stoatworks-labs/canary/docs/renders/bottom.png

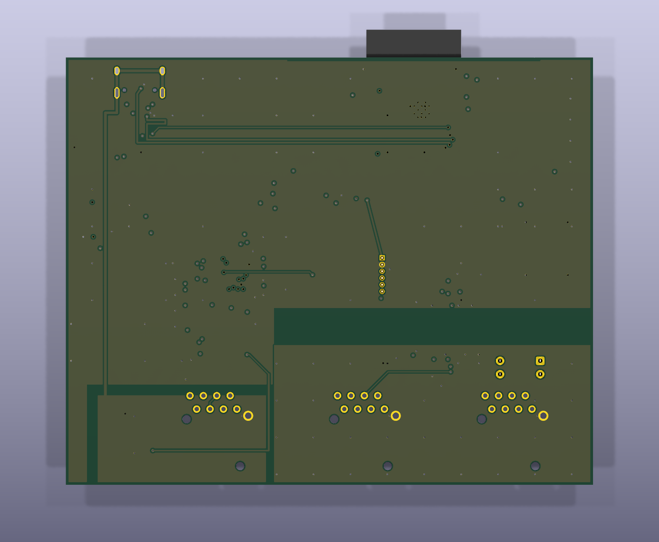
docs/renders/bottom.png
