stoatworks-labs/canary/docs/renders/top.png

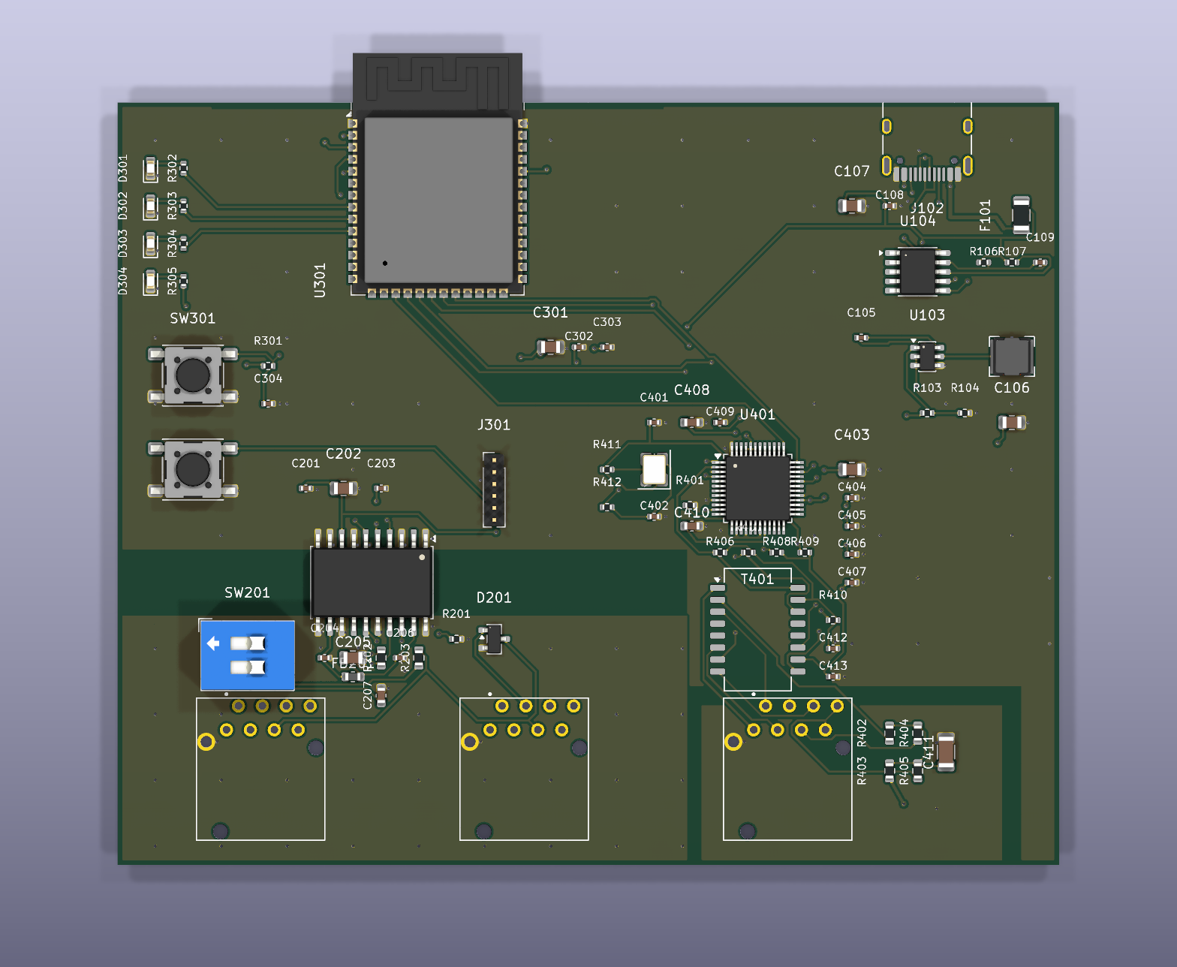
docs/renders/top.png
