stoatworks-labs/canary/hardware/fab/generic/canary-bom.csv

Item | Qty | References | Value | Footprint | Description | Manufacturer | MPN | LCSC | Mount | DNP | Notes
1 | 14 | C105,C108,C201,C203,C204,C206,C302-C304,C404-C407,C409 | 100nF (BST) / 100nF / 100nF (VBG) | C_0402_1005Metric | CAP CER 100nF 16V X7R 0402 | Samsung Electro-Mechanics | CL05B104KO5NNNC | C1525 | smt |  | DigiKey UK 8,392,367 in stock 2026-07-26
2 | 2 | C106,C301 | 22uF 16V / 22uF | C_0805_2012Metric | CAP CER 22uF 25V X5R 0805 | Samsung Electro-Mechanics | CL21A226MAQNNNE | C45783 | smt |  | was CL21A226MAQNNNE (Samsung): OBSOLETE, no longer manufactured; even Samsung's own CL21A226MAYNNNE replacement is out of stock. Substitute 55,097 in stock 2026-07-26. Same 0805, 25V X5R. | PCB Train UK alternate: KYOCERA AVX KGM21AR51E226MU
3 | 4 | C107,C202,C205,C403 | 10uF 16V / 10uF | C_0805_2012Metric | CAP CER 10uF 25V X5R 0805 | Samsung Electro-Mechanics | CL21A106KAYNNNE | C15850 | smt |  | was CL21A106KAYNNNE (Samsung): 0 stock at DigiKey UK, 49-week factory lead time. Substitute 275,536 in stock 2026-07-26. Same 0805 land pattern, same 25V X5R. | PCB Train UK alternate: Taiyo Yuden TMK212BBJ106KGHT
4 | 1 | C109 | 1uF | C_0402_1005Metric | CAP CER 1uF 25V X5R 0402 | Samsung Electro-Mechanics | CL05A105KA5NQNC | C52923 | smt |  | DigiKey UK 1,871,894 in stock 2026-07-26
5 | 1 | C207 | 4.7nF | C_0603_1608Metric | CAP CER 4.7nF 50V X7R 0603 | FH (Guangdong Fenghua Advanced Tech) | 0603B472K500NT | C53987 | smt |  | was 0603B472K500NT (Fenghua): China-domestic, not stocked in the West. Substitute 3,125,426 in stock 2026-07-26. | PCB Train UK alternate: Samsung Electro-Mechanics CL10B472KB8NNNC
6 | 2 | C401,C402 | 18pF | C_0402_1005Metric | CAP CER 18pF 50V C0G/NP0 0402 | FH (Guangdong Fenghua Advanced Tech) | 0402CG180J500NT | C1549 | smt |  | was 0402CG180J500NT (Fenghua): China-domestic. Substitute 542,765 in stock 2026-07-26. C0G confirmed - these are the crystal load caps, so the dielectric matters. | PCB Train UK alternate: Samsung Electro-Mechanics CL05C180JB5NNNC
7 | 2 | C408,C410 | 4.7uF (1V2O) / 4.7uF (TOCAP) | C_0603_1608Metric | CAP CER 4.7uF 16V X5R 0603 | Samsung Electro-Mechanics | CL10A475KO8NNNC | C19666 | smt |  | DigiKey UK 118,638 in stock 2026-07-26
8 | 1 | C411 | 1nF 2kV | C_1206_3216Metric | CAP CER 1nF 2kV X7R 1206 | FH (Guangdong Fenghua Advanced Tech) | 1206B102K202NT | C9196 | smt |  | was 1206B102K202NT (Fenghua): China-domestic. Substitute confirmed 2000V X7R 1206, 295,090 in stock 2026-07-26. SAFETY-RELEVANT: this is the capacitor bridging the CAN isolation barrier - the 2kV rating is the reason it is a 1206. | PCB Train UK alternate: YAGEO CC1206KKX7RDBB102
9 | 1 | C412 | 10nF (TCT) | C_0402_1005Metric | CAP CER 10nF 50V X7R 0402 | Samsung Electro-Mechanics | CL05B103KB5NNNC | C15195 | smt |  | DigiKey UK 6,151,308 in stock 2026-07-26
10 | 1 | C413 | 6.8nF (RCT) | C_0402_1005Metric | CAP CER 6.8nF 50V X7R 0402 | YAGEO | CC0402KRX7R9BB682 | C93654 | smt |  | DigiKey UK 76,814 in stock 2026-07-26
11 | 1 | D201 | NUP2105L | SOT-23 | TVS DIODE 24VWM 44VC SOT-23 | TECH PUBLIC | NUP2105LT1G | C2890118 | smt |  | MANUFACTURER CORRECTED: the JLCPCB BOM credited this to 'TECH PUBLIC', which is a clone house. onsemi is the originator and DigiKey UK stocks it at GBP 0.33 2026-07-26. Buy the onsemi part - it is an ESD device on an isolated bus.
12 | 3 | D301,D303,D304 | LAN (green) / CAN (green) / ON (green) | LED_0603_1608Metric | LED GREEN CLEAR 0603 SMD | Hubei KENTO Elec | KT-0603G | C12624 | smt |  | was KT-0603G (Hubei KENTO): China-domestic. Substitute 1,892,900 in stock 2026-07-26. Active low, 1k series resistor - forward voltage is not critical. | PCB Train UK alternate: Lite-On Inc. LTST-C190KGKT
13 | 1 | D302 | ERR (red) | LED_0603_1608Metric | LED RED CLEAR 0603 SMD | Hubei KENTO Elec | KT-0603R | C2286 | smt |  | was KT-0603R (Hubei KENTO): China-domestic. Substitute 1,033,054 in stock 2026-07-26. Same Lite-On family as the greens, so one series and one datasheet covers all four LEDs. | PCB Train UK alternate: Lite-On Inc. LTST-C190KRKT
14 | 1 | F101 | PTC 1.1A | Fuse_1206_3216Metric | PTC RESETTABLE FUSE 1.1A HOLD 16V 1206 | BHFUSE | BSMD1206-110-30V | C21714343 | smt |  | was BSMD1206-110-30V (BHFUSE): China-domestic, rated 30V. **THE 30V RATING CANNOT BE MET IN 1206.** A survey of DigiKey UK's 1206 PPTCs at 1.1A hold found 16V to be the highest available (this part, 3,066 in stock); everything else was 6V. 16V is comfortable for the 5V VBUS this board actually runs on - CH224K is configured for a 5V contract - but it does NOT cover the 20V a PD supply could present if that ever changed. DESIGNER TO CONFIRM. The alternative is a larger package in rev B. Verified 2026-07-26. | PCB Train UK alternate: Bourns Inc. MF-NSMF110/16X-2
15 | 1 | FB201 | 600R@100MHz | L_0603_1608Metric | FERRITE BEAD 600 OHM @ 100MHz 0603 | Murata Electronics | BLM18AG601SN1D | C19330 | smt |  | DigiKey UK 2,148,543 in stock 2026-07-26
16 | 1 | J102 | USB-C 16P | USB_C_Receptacle_HRO_TYPE-C-31-M-12 | CONN RCPT USB-C 16P SMD | Korean Hroparts Elec | TYPE-C-31-M-12 | C165948 | smt |  | China-domestic, and the KiCad land pattern (USB_C_Receptacle_HRO_TYPE-C-31-M-12) is drawn for THIS part. Western 16-pin USB-C receptacles exist but pin and shell geometry vary between makers, so a swap cannot be assumed to drop in. FREE ISSUE is the low-risk route: buy from LCSC and send them in. If PCB Train are to source it, they must confirm the mechanical drawing against the footprint first.
17 | 3 | J201,J202,J401 | etherCON NE8FBH CAN A / etherCON NE8FBH CAN B / etherCON NE8FBH LAN | Neutrik_etherCON_NE8FBH | CONN RCPT ETHERCON CAT5 B-SERIES PCB | Neutrik | NE8FBH |  | tht |  | MPN ADDED - this line was blank on the JLCPCB BOM because JLC cannot hand-fit it. PCB Train do through-hole assembly, so unlike JLCPCB they CAN fit these. DigiKey UK GBP 6.31 2026-07-26.
18 | 1 | J301 | UART/debug 1.27mm | PinHeader_1x06_P1.27mm_Vertical | HEADER 1x6 1.27mm PITCH VERTICAL THROUGH-HOLE - NOT FITTED | DO NOT FIT | DO NOT FIT |  | tht |  | DO NOT FIT. A 1x6 1.27mm SINGLE-ROW THROUGH-HOLE header is an awkward part - the 1.27mm parts carried by DigiKey UK are all either dual-row or SMD (M50-3600642, 20021121-00006T4LF, FTSH-106-01-L-DV all checked and all wrong). This is only a UART/debug header and the ESP32-S3's native USB already gives console access, so it is not needed to bring the board up. Leave the holes empty and fit a header by hand if ever wanted.
19 | 1 | L102 | 2.2uH 2A | L_Bourns-SRN4018 | INDUCTOR 2.2uH 2.9A SHIELDED DRUM | BOURNS | SRN4018-2R2M | C913207 | smt |  | DigiKey UK 86,769 in stock 2026-07-26
20 | 1 | R103 | 31.6k 1% | R_0402_1005Metric | RES 31.6k 1% 0402 | UNI-ROYAL(Uniroyal Elec) | 0402WGF3162TCE | C11463 | smt |  | was UNI-ROYAL (China-domestic, not stocked in the West). DigiKey UK 1,526,832 in stock 2026-07-26. | PCB Train UK alternate: YAGEO RC0402FR-0731K6L
21 | 3 | R104,R107,R301 | 10k 1% / 10k | R_0402_1005Metric | RES 10k 1% 0402 | UNI-ROYAL(Uniroyal Elec) | 0402WGF1002TCE | C25744 | smt |  | was UNI-ROYAL (China-domestic). NOTE the -13 series code, not -07: RC0402FR-0710KL is the same value but had only 762 in stock, whereas -13 had 79,602 2026-07-26. Electrically identical. | PCB Train UK alternate: YAGEO RC0402FR-1310KL
22 | 5 | R106,R302-R305 | 1k | R_0402_1005Metric | RES 1k 1% 0402 | UNI-ROYAL(Uniroyal Elec) | 0402WGF1001TCE | C11702 | smt |  | was UNI-ROYAL (China-domestic, not stocked in the West). DigiKey UK 11,751,037 in stock 2026-07-26. | PCB Train UK alternate: YAGEO RC0402FR-071KL
23 | 2 | R201,R412 | 0R / 0R (XO series) | R_0402_1005Metric | RES 0 ohm jumper 0402 | UNI-ROYAL(Uniroyal Elec) | 0402WGF0000TCE | C17168 | smt |  | was UNI-ROYAL (China-domestic). DigiKey UK 10,726,477 in stock 2026-07-26. J-series because a jumper has no meaningful tolerance. | PCB Train UK alternate: YAGEO RC0402JR-070RL
24 | 2 | R202,R203 | 62R | R_0603_1608Metric | RES 62R 1% 0603 | UNI-ROYAL(Uniroyal Elec) | 0603WAF620JT5E | C23222 | smt |  | was UNI-ROYAL (China-domestic, not stocked in the West). DigiKey UK 51,612 in stock 2026-07-26. | PCB Train UK alternate: YAGEO RC0603FR-0762RL
25 | 1 | R401 | 12.4k 1% | R_0402_1005Metric | RES 12.4k 1% 0402 | UNI-ROYAL(Uniroyal Elec) | 0402WGF1242TCE | C11692 | smt |  | was UNI-ROYAL (China-domestic, not stocked in the West). DigiKey UK 582,138 in stock 2026-07-26. | PCB Train UK alternate: YAGEO RC0402FR-0712K4L
26 | 4 | R402-R405 | 75R | R_0603_1608Metric | RES 75R 1% 0603 | UNI-ROYAL(Uniroyal Elec) | 0603WAF750JT5E | C4275 | smt |  | was UNI-ROYAL (China-domestic, not stocked in the West). DigiKey UK 254,084 in stock 2026-07-26. | PCB Train UK alternate: YAGEO RC0603FR-0775RL
27 | 4 | R406-R409 | 49.9R 1% | R_0402_1005Metric | RES 49.9R 1% 0402 | UNI-ROYAL(Uniroyal Elec) | 0402WGF499JTCE | C25120 | smt |  | was UNI-ROYAL (China-domestic, not stocked in the West). DigiKey UK 1,249,726 in stock 2026-07-26. | PCB Train UK alternate: YAGEO RC0402FR-0749R9L
28 | 1 | R410 | 10R 1% | R_0402_1005Metric | RES 10R 1% 0402 | UNI-ROYAL(Uniroyal Elec) | 0402WGF100JTCE | C25077 | smt |  | was UNI-ROYAL (China-domestic, not stocked in the West). DigiKey UK 3,567,505 in stock 2026-07-26. | PCB Train UK alternate: YAGEO RC0402FR-0710RL
29 | 1 | R411 | 1M | R_0402_1005Metric | RES 1M 1% 0402 | UNI-ROYAL(Uniroyal Elec) | 0402WGF1004TCE | C26083 | smt |  | was UNI-ROYAL (China-domestic, not stocked in the West). DigiKey UK 1,711,666 in stock 2026-07-26. | PCB Train UK alternate: YAGEO RC0402FR-071ML
30 | 1 | SW201 | TERMINATE 120R | SW_DIP_SPSTx02_Slide_9.78x7.26mm_W7.62mm_P2.54mm | SWITCH DIP SLIDE SPST x2 2.54mm | CTS Electrocomponents | 206-2ST |  | tht |  | was unspecified on the JLCPCB BOM. 206-2ST is a 2-position SPST slide DIP switch, DigiKey UK 12,933 in stock 2026-07-26. CHECK THE FOOTPRINT: the board uses SW_DIP_SPSTx02_Slide_9.78x7.26mm_W7.62mm_P2.54mm and this part's body/row spacing needs confirming against it. This is the CAN bus termination switch - a passive mechanical switch, so getting it wrong costs a rework, not a redesign.
31 | 2 | SW301,SW302 | RESET / BOOT | SW_SPST_PTS645Sx43SMTR92 | SWITCH TACTILE SPST-NO 6mm SMD | C&K | PTS645SK43SMTR92LFS | C221871 | smt |  | DigiKey UK 103,472 in stock 2026-07-26
32 | 1 | T401 | PT61017PEL | Transformer_Ethernet_Bourns_PT61017PEL | XFMR LAN 10/100 BASE-T 350uH 1CT:1CT SMD | BOURNS | PT61017PEL | C124001 | smt |  | DigiKey UK 7,881 in stock 2026-07-26
33 | 1 | U103 | AP63200WU | TSOT-23-6 | IC REG BUCK ADJ 2A TSOT-23-6 | Diodes Incorporated | AP63200WU-7 | C2071868 | smt |  | **SUPPLY RISK.** DigiKey UK showed 0 stock and a 40-WEEK manufacturer lead time 2026-07-26; the AP63201/03/05 siblings were also at zero. It IS plentiful at LCSC (C2071868). Ask PCB Train to check their own channels (Mouser/RS were unreachable from here so are unchecked) and be ready to free-issue this one too. Do NOT let a substitute buck be chosen for you: the output is set by an external divider (R103/R401) and a fixed-output sibling would silently ignore it.
34 | 1 | U104 | CH224K | SSOP-10-1EP_3.9x4.9mm_P1mm_EP2.1x3.3mm | IC USB PD SINK CONTROLLER SSOP-10 | WCH(Jiangsu Qin Heng) | CH224K | C970725 | smt |  | **NO WESTERN SOURCE EXISTS.** DigiKey UK returns no results for CH224K at all 2026-07-26 - WCH sell through Chinese channels only. There is no cross-reference to give PCB Train, so FREE ISSUE is the only option short of redesigning the power input around a western PD controller. Buy from LCSC (C970725) and send them in with the boards.
35 | 1 | U201 | ADM3053BRWZ | SOIC-20W_7.5x12.8mm_P1.27mm | IC TXRX CAN ISOLATED w/ isoPower SOIC-20W | Analog Devices | ADM3053BRWZ-REEL7 | C117821 | smt |  | MPN shortened from ADM3053BRWZ-REEL7: '-REEL7' only specifies a 7-inch reel, and DigiKey UK lists the plain part (GBP 11.91) rather than that suffix 2026-07-26. Let the supplier choose packaging. Most expensive part on the board - check its price on the quote. | PCB Train UK alternate: Analog Devices Inc. ADM3053BRWZ
36 | 1 | U301 | ESP32-S3-WROOM-1-N8 | ESP32-S3-WROOM-1 | MODULE ESP32-S3 WIFI/BT 8MB FLASH | Espressif Systems | ESP32-S3-WROOM-1-N8 | C2913198 | smt |  | DigiKey UK GBP 4.29, in stock 2026-07-26
37 | 1 | U401 | W5500 | LQFP-48_7x7mm_P0.5mm | IC ETHERNET MAC+PHY SPI LQFP-48 | WIZNET | W5500 | C32843 | smt |  | DigiKey UK GBP 2.87, in stock 2026-07-26
38 | 1 | Y401 | 25MHz 10ppm | Crystal_SMD_3225-4Pin_3.2x2.5mm | CRYSTAL 25MHz 12pF 3.2x2.5mm 4-SMD | YXC Crystal Oscillators | X322525MOB4SI | C9006 | smt |  | was X322525MOB4SI (YXC): China-domestic. LOAD CAPACITANCE PRESERVED at 12pF, which is the number that matters - C401/C402 are 18pF precisely because CL is 12pF, so a CL=18pF crystal would need those changed to ~30pF and that is a schematic edit, not a substitution. STABILITY IS RELAXED: +/-30ppm against the original +/-10ppm. IEEE 802.3 allows +/-100ppm on 100BASE-TX, so 30ppm is comfortably inside what the W5500 needs - but it is a relaxation of a stated spec, so DESIGNER TO CONFIRM. Only 723 in stock 2026-07-26: fine for a handful of prototypes, reserve early for a run. | PCB Train UK alternate: Abracon LLC ABM8-25.000MHZ-12-R40-D3Y-T
