stoatworks-labs/canary/hardware/enclosure/3dp-tube/canary_case_assembly.step

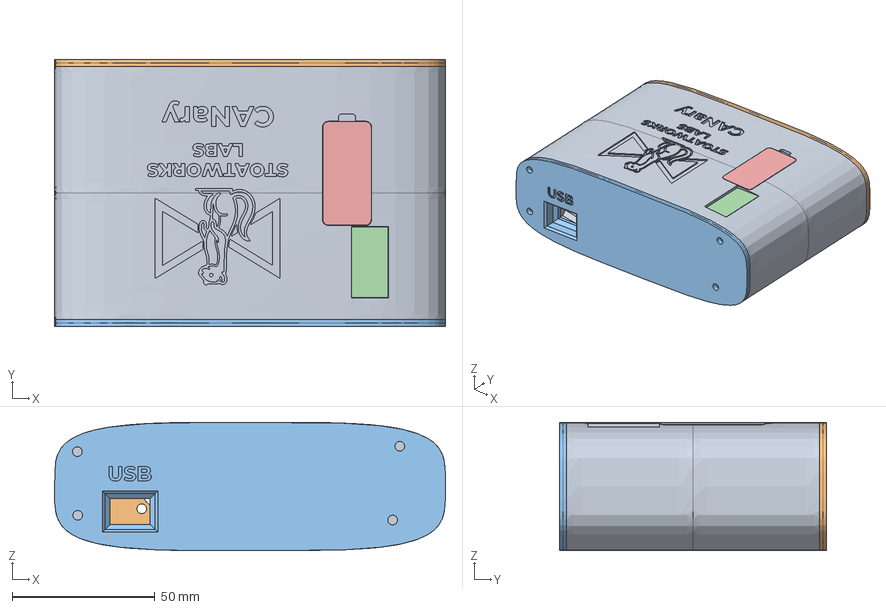
[picture p4: CAD file, 2026-09-27]
hardware/enclosure/3dp-tube/canary_case_assembly.step
137.0 x 93.5 x 45.0 mm
canary_tube
canary_end_front
canary_end_rear
canary_led_insert
canary_switch_cover
