stoatworks-labs/canary/hardware/enclosure/3dp-tube/canary_tube.step

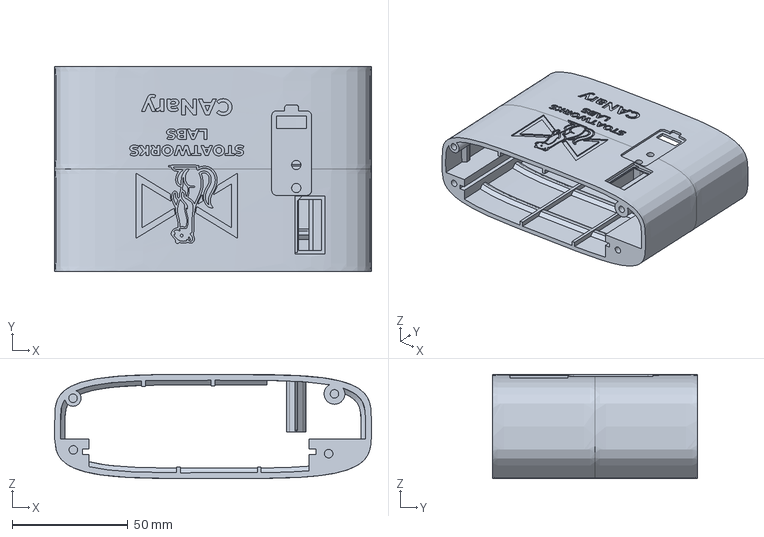
[picture p5: CAD file, 2026-09-27]
hardware/enclosure/3dp-tube/canary_tube.step
137.0 x 88.5 x 45.0 mm
