stoatworks-labs/canary/hardware/enclosure/canary-case-absgf-0.4-tube.3mf

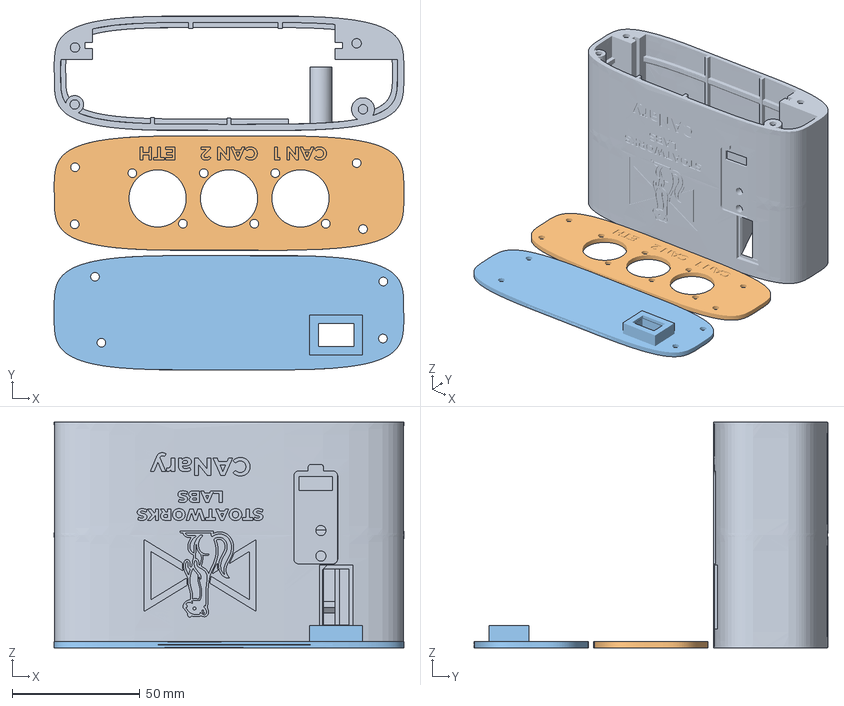
[picture p6: CAD file, 2026-09-27]
hardware/enclosure/canary-case-absgf-0.4-tube.3mf
137.1 x 138.7 x 88.5 mm
CANary case - body (one piece)
CANary case - end front (3x etherCON)
CANary case - end rear (USB-C)
