stoatworks-labs/canary/hardware/enclosure/jig/canary_jig_peg.step

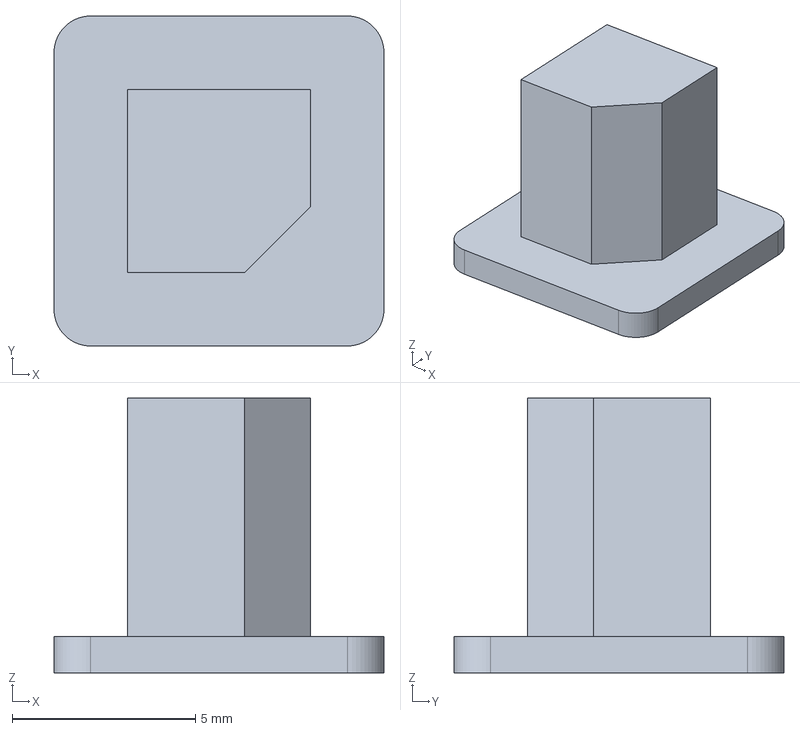
[picture p7: CAD file, 2026-09-27]
hardware/enclosure/jig/canary_jig_peg.step
9.00 x 9.00 x 7.50 mm
