stoatworks-labs/canary/hardware/enclosure/bambu/print-tube/canary_switch_cover.stl

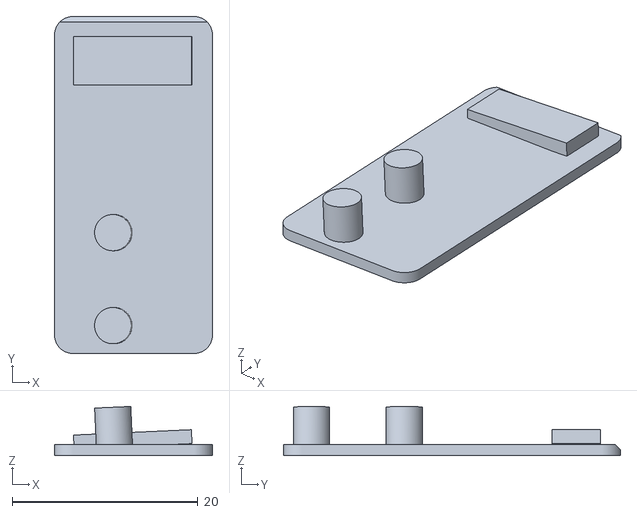
[picture p8: CAD file, 2026-09-27]
hardware/enclosure/bambu/print-tube/canary_switch_cover.stl
17.0 x 36.2 x 5.28
