stoatworks-labs/canary/hardware/enclosure/canary-4up-absgf-0.4-tube-x4.3mf

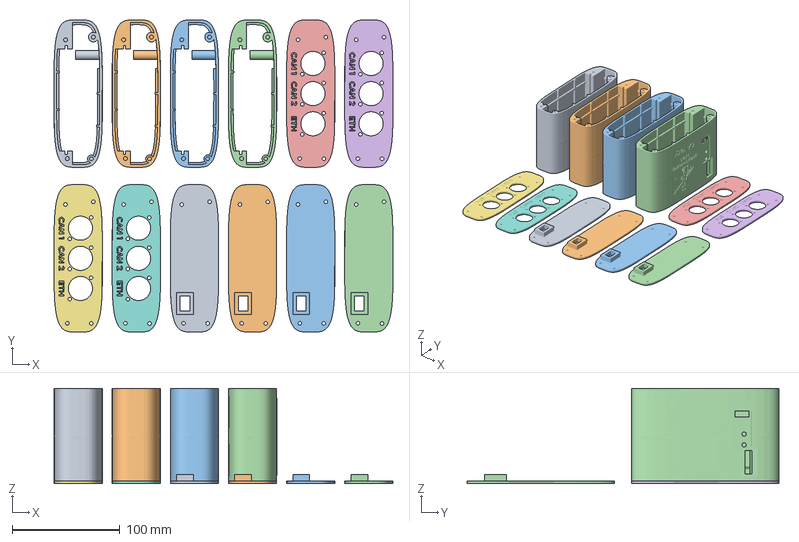
[picture p9: CAD file, 2026-09-27]
hardware/enclosure/canary-4up-absgf-0.4-tube-x4.3mf
314.9 x 290.1 x 88.5 mm
CANary case - body (one piece) x 4
CANary case - end front (3x etherCON) x 4
CANary case - end rear (USB-C) x 4
