stoatworks-labs/canary/hardware/enclosure/jig/canary_jig_plate.step

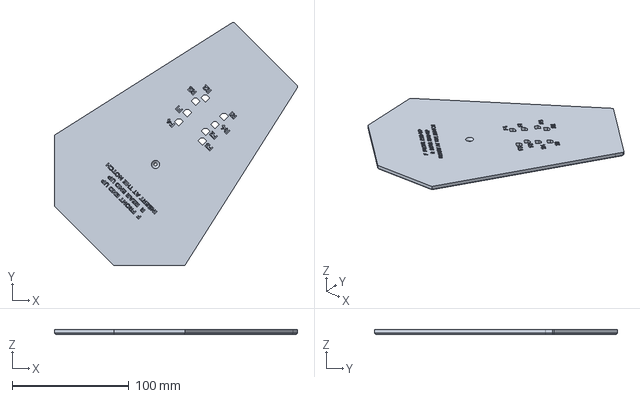
[picture p10: CAD file, 2026-09-27]
hardware/enclosure/jig/canary_jig_plate.step
207.7 x 207.7 x 4.00 mm
