stoatworks-labs/canary/hardware/enclosure/3dp-tube/canary_switch_cover.step

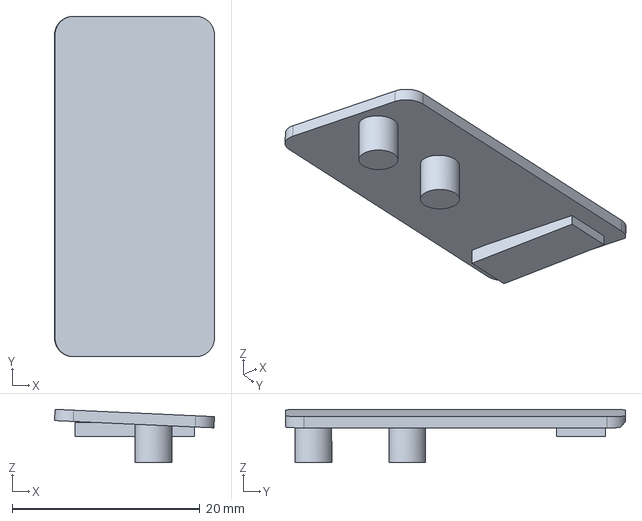
[picture p11: CAD file, 2026-09-27]
hardware/enclosure/3dp-tube/canary_switch_cover.step
17.0 x 36.2 x 5.68 mm
