stoatworks-labs/canary/hardware/enclosure/bambu/print-tube/canary_end_front.stl

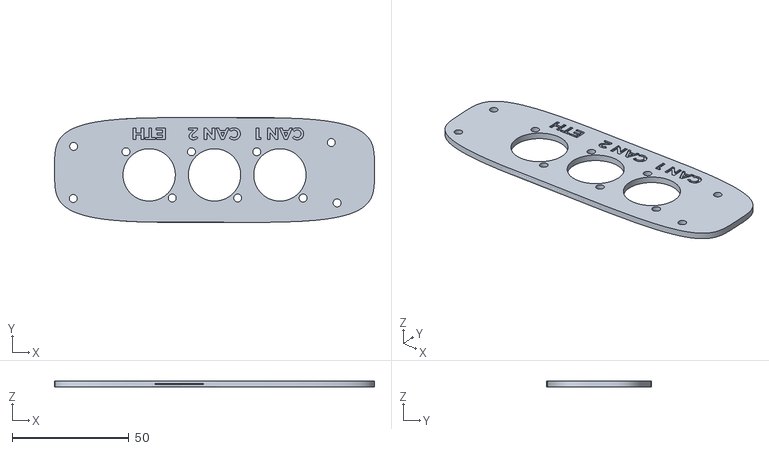
[picture p12: CAD file, 2026-09-26]
hardware/enclosure/bambu/print-tube/canary_end_front.stl
137.1 x 44.9 x 2.50
