stoatworks-labs/canary/hardware/enclosure/jig/canary_jig_nest.step

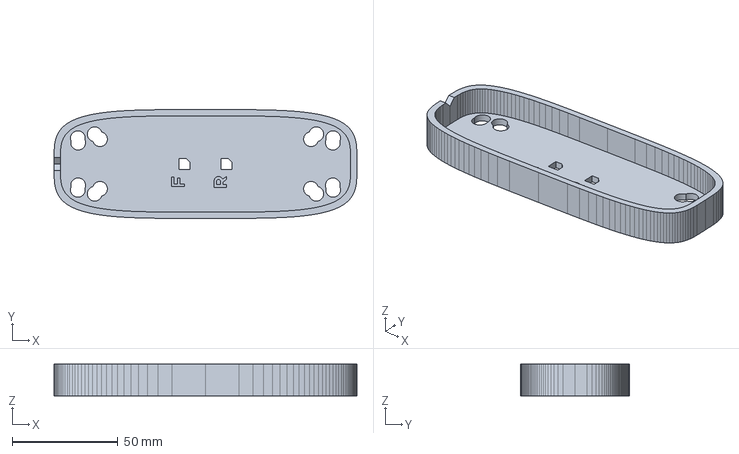
[picture p13: CAD file, 2026-09-27]
hardware/enclosure/jig/canary_jig_nest.step
143.6 x 51.6 x 15.0 mm
