stoatworks-labs/canary/hardware/enclosure/3dp-tube/canary_end_rear.step

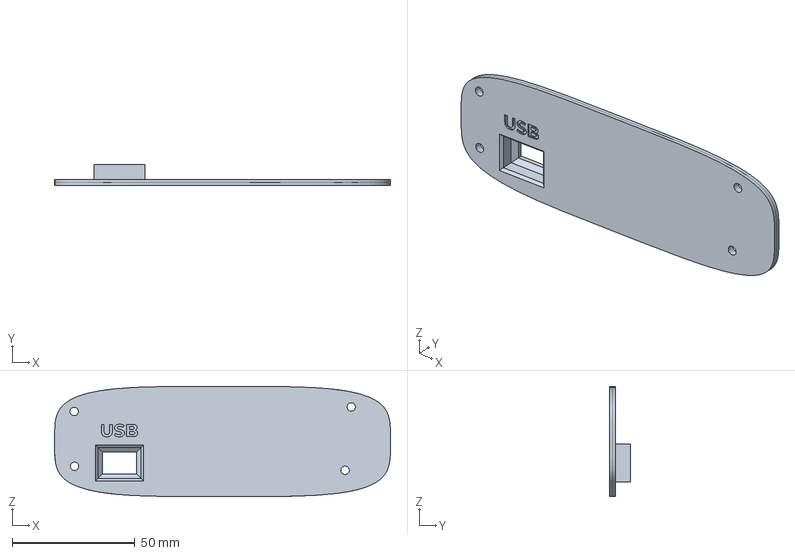
[picture p14: CAD file, 2026-09-27]
hardware/enclosure/3dp-tube/canary_end_rear.step
137.0 x 8.70 x 45.0 mm
