stoatworks-labs/canary/hardware/enclosure/canary-white-x4-pla-0.4-tube.3mf

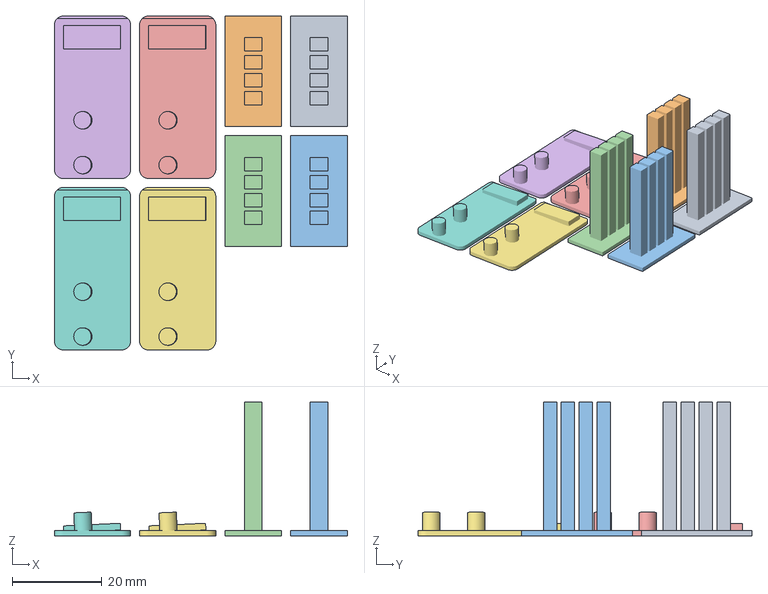
[picture p15: CAD file, 2026-09-27]
hardware/enclosure/canary-white-x4-pla-0.4-tube.3mf
65.4 x 74.5 x 29.8 mm
CANary case - LED window insert (PLA) x 4
CANary case - switch cover (PLA) x 4
