stoatworks-labs/canary/hardware/enclosure/3dp-tube/canary_led_insert.step

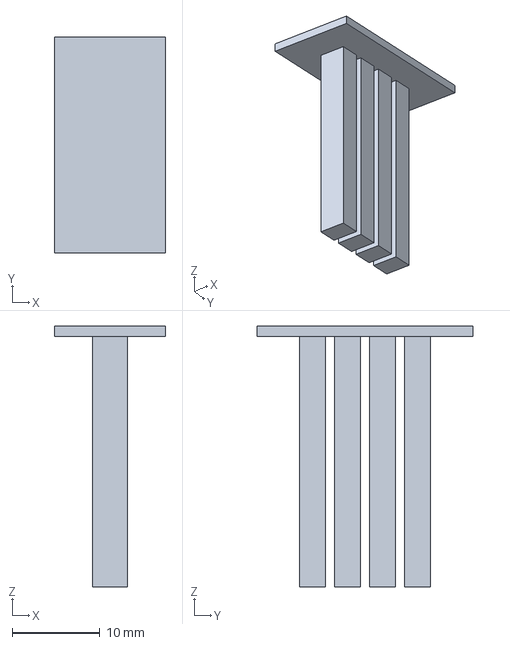
[picture p16: CAD file, 2026-09-27]
hardware/enclosure/3dp-tube/canary_led_insert.step
12.7 x 24.7 x 29.8 mm
