stoatworks-labs/canary/hardware/enclosure/canary-insert-jig-pla-0.4-jig.3mf

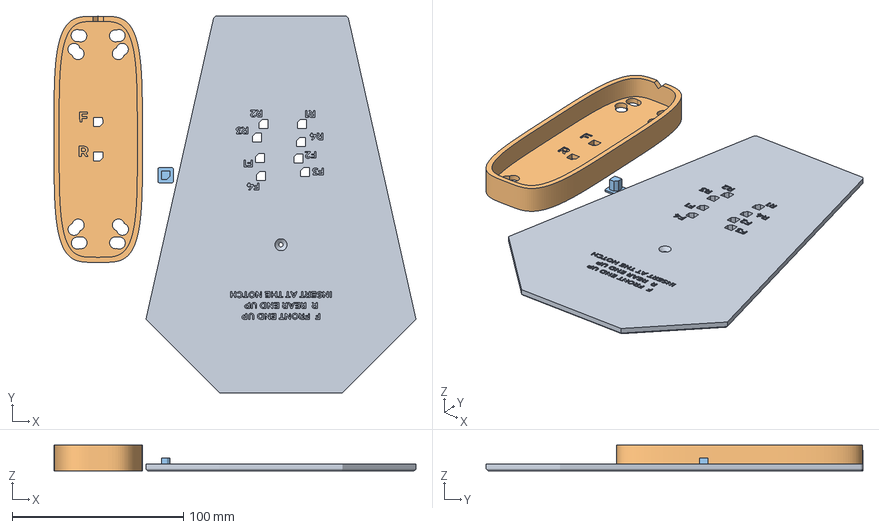
[picture p17: CAD file, 2026-09-27]
hardware/enclosure/canary-insert-jig-pla-0.4-jig.3mf
211.2 x 219.6 x 15.0 mm
canary_jig_plate.stl
canary_jig_nest.stl
canary_jig_peg.stl
