stoatworks-labs/canary/(list of files, cad)

Other CAD files:
hardware/enclosure/bambu/print-tube/canary_tube.stl
hardware/enclosure/canary-switchcover-pla-0.4-tube.3mf
hardware/enclosure/bambu/print-tube/canary_end_rear.stl
hardware/enclosure/bambu/print-tube/canary_led_insert.stl
hardware/enclosure/canary-rearplate-absgf-0.4-tube.3mf
hardware/enclosure/3dp-tube/canary_end_front.step
hardware/enclosure/3dp-tube/dbcanary_led_insert.step
hardware/enclosure/3dp-tube/dbcanary_end_rear.step
hardware/enclosure/3dp-tube/dbcanary_end_front.step
hardware/enclosure/3dp-tube/canary_end_front.stl
hardware/enclosure/3dp-tube/canary_end_rear.stl
hardware/enclosure/3dp-tube/canary_led_insert.stl
hardware/enclosure/3dp-tube/canary_switch_cover.stl
hardware/enclosure/3dp-tube/canary_tube.stl
hardware/enclosure/jig/canary_jig_nest.stl
hardware/enclosure/jig/canary_jig_peg.stl
hardware/enclosure/jig/canary_jig_plate.stl
