stoatworks-labs/canary/hardware/fab/test/PROBE-POINTS.csv

id | pad | net | signal | group | instrument | expect | failure_means | confidence | x_mm | y_mm | side | measured | pass_fail
P1 | F101.1 | VBUS_RAW | USB-C VBUS, before the PTC | PWR | DMM-V | 4.75 - 5.25 V | no volts here = cable, connector or source, not the board | spec | 116.0 | 32.4 | F
P2 | C107.1 | VCC_5V | 5 V rail, after the PTC | PWR | DMM-V | 4.70 - 5.25 V; must be within 100 mV of P1 at idle | a big P1-P2 gap means F101 is warm and current-limiting - look for a short | derived | 97.05 | 30.0 | F
P3 | C301.1 | VCC_3V3 | 3.3 V rail at the MCU | PWR | DMM-V | 3.23 - 3.43 V (nominal 3.33 V) | out of range = AP63200 feedback network or the buck itself | derived | 65.05 | 45.0 | F
P4 | U103.1 | FB2 | AP63200 feedback node | PWR | DMM-V | 0.784 - 0.816 V (0.8 V reference) | 0.8 V here with a wrong P3 means R103/R104 are wrong or misplaced | spec | 104.862 | 45.05 | F
P5 | C109.1 | PD_VDD | CH224K supply, fed through R106 1k | PWR | DMM-V | 3.3 - 5.1 V | 0 V = R106 open or U104 shorted; the exact value depends on CH224K Iq, which we have not measured | predicted | 117.52 | 36.0 | F
P6 | U104.10 | PD_PG | CH224K power-good to GPIO18 | PWR | DMM-V | logic level, stable; note which level a good board shows | the polarity is unverified - record it on board #1 and make that the limit | predicted | 107.638 | 35.0 | F
P7 | U103.5 | SW2 | buck switching node | PWR | SCOPE | 0 -> 5 V square, 500 kHz +/- 20 %, duty 62 - 72 % | no switching = buck not enabled; wrong duty = wrong input or feedback | derived | 107.138 | 46.0 | F
P8 | C105.2 | BST2 | bootstrap cap, high side | PWR | SCOPE | SW2 waveform offset up by ~4.5 - 5 V | flat = C105 open, and the high-side FET will not turn on properly | derived | 99.48 | 44.0 | F
P9 | C107.2 | GND | SYSTEM GROUND reference | PWR | VISUAL | clip every system-side ground lead here and nowhere else | grounding to the CAN side defeats the isolation barrier under test | derived | 98.95 | 30.0 | F
P10 | L102.2 | VCC_3V3 | 3.3 V at the inductor output | PWR | DMM-V | same as P3 within 20 mV | a difference means a resistive joint between the buck and the load | derived | 116.525 | 46.0 | F
M1 | R301.2 | EN | ESP32-S3 enable | MCU | DMM-V | 3.23 - 3.43 V after ~10 ms | stuck low = the S3 is held in reset; check R301, C304 and SW301 | derived | 36.51 | 47.0 | F
M2 | J301.1 | VCC_3V3 | debug header pin 1 | MCU | DMM-V | 3.23 - 3.43 V | the header is the fallback console when USB will not enumerate | derived | 60.0 | 57.0 | F
M3 | J301.3 | UART0_TXD | debug header pin 3, board -> host | MCU | SCOPE | idle high 3.3 V, 115200 baud bursts at reset | silent at reset = the S3 is not running its ROM bootloader | derived | 60.0 | 59.54 | F
M4 | U301.11 | PD_PG | PD power-good at the MCU | MCU | DMM-CONT | continuous with P6 | open = the PD_PG track or a module pad joint | derived | 45.25 | 33.94 | F
M5 | R305.1 | VCC_3V3 | D304 'ON' LED feed | MCU | DMM-V | 3.23 - 3.43 V, and D304 lit | rail present but D304 dark = LED fitted backwards or R305 open | derived | 27.0 | 38.51 | F
M6 | R302.1 | LED_LAN | D301 drive from GPIO15 | MCU | DMM-V | ACTIVE HIGH: ~3.3 V when lit, ~0 V when dark | see the polarity note in BENCH-BRINGUP.md - the schematic is active high | derived | 27.0 | 26.51 | F
E1 | C408.1 | ETH_1V2 | W5500 internal 1.2 V regulator | ETH | DMM-V | 1.08 - 1.32 V | 0 V = W5500 unpowered or 1V2O shorted; the chip cannot work without it | spec | 80.225 | 53.0 | F
E2 | C409.1 | ETH_VBG | W5500 bandgap decoupling | ETH | DMM-V | 1.1 - 1.4 V | informational; the datasheet does not publish a limit | predicted | 83.52 | 53.0 | F
E3 | C410.1 | ETH_TOCAP | W5500 TX driver reservoir | ETH | DMM-V | 1.0 - 1.4 V | informational; do not fail a board on this alone | predicted | 80.225 | 64.0 | F
E4 | R401.1 | ETH_EXRES | W5500 bias resistor, 12.4k to GND | ETH | DMM-R | 12.28 - 12.52 kohm, POWER OFF | wrong value skews every analogue bias in the PHY - link may come up and still fail | spec | 80.29 | 61.8 | F
E5 | R412.1 | ETH_XO_DRV | 25 MHz crystal driver, chip side | ETH | SCOPE | 25.000 MHz +/- 250 Hz, roughly sinusoidal, 0.8 - 2.0 Vpp | probe capacitance can stop the oscillator - only probe this if E1 or the VERSIONR read has already failed | derived | 71.49 | 62.0 | F
E6 | U401.32 | ETH_CSn | W5500 chip select | ETH | LA | idle high, one low pulse per SPI transaction | stuck low or stuck high = the SPI bus is dead in one direction | derived | 92.162 | 59.25 | F
E7 | U401.33 | SPI_SCK | SPI clock | ETH | LA | 20 MHz +/- 5 % while CSn is low | no clock = the S3 SPI peripheral or the track | derived | 92.162 | 58.75 | F
E8 | U401.35 | SPI_MOSI | SPI host -> W5500 | ETH | LA | first transaction after reset is 00 39 00 - the VERSIONR address | the address phase proves the driver is configured 16/8 bits | derived | 92.162 | 57.75 | F
E9 | U401.34 | SPI_MISO | SPI W5500 -> host | ETH | LA | 0x04 in the 4th byte of that transaction | 0x00 or 0xFF = W5500 not answering: supply, crystal or reset | spec | 92.162 | 58.25 | F
E10 | U401.37 | ETH_RSTn | W5500 reset, from GPIO9 | ETH | DMM-V | 3.23 - 3.43 V once firmware has run | low = held in reset, and every SPI read returns 0x00 | derived | 90.75 | 55.837 | F
E11 | R410.2 | ETH_TCT | transmit centre tap, PHY side of R410 10R | ETH | DMM-V | 20 - 120 mV BELOW the 3V3 rail with the link up; equal to it with no link | no drop across R410 with a link means the PHY transmitter is not driving | derived | 96.51 | 74.0 | F
E12 | C411.1 | BOB_SMITH | Bob Smith termination node | ETH | DMM-V | under 0.5 V DC referenced to GND | volts here means something is feeding the spare pairs - suspect a PoE port | derived | 108.0 | 89.475 | F
K1 | C204.1 | VISO_RAW | ADM3053 isoPower output | CAN | DMM-V | 4.5 - 5.5 V, measured to CAN_GND (K3), NOT to GND | 0 V = the isolated DC-DC has not started; nothing on the CAN side can work | spec | 41.52 | 78.0 | F
K2 | C206.1 | VISO | isolated 5 V after FB201 | CAN | DMM-V | within 100 mV of K1 | a gap across FB201 means it is drawing far more than expected | derived | 49.52 | 78.0 | F
K3 | C206.2 | CAN_GND | ISOLATED GROUND reference | CAN | VISUAL | every CAN-side lead clips here; NEVER share a clip with P9 | one shared clip and the isolation test passes on a board that is not isolated | derived | 50.48 | 78.0 | F
K4 | R201.1 | CAN_RS | ADM3053 slope control | CAN | DMM-V | under 0.3 V to CAN_GND - R201 is 0R, so high-speed mode | volts here = R201 missing, and the transceiver drops to standby | spec | 55.49 | 76.0 | F
K5 | J201.4 | CANH | bus high, at CAN jack A (pin 4) | CAN | DMM-V | idle 2.3 - 2.7 V to CAN_GND; K5-K6 reads 118-130 ohm with SW201 IN, over 10 kohm with it OUT | 0 V or 5 V = the transceiver is stuck dominant, which jams the whole bus | spec | 35.37 | 83.105 | F
K6 | J201.5 | CANL | bus low, at CAN jack A (pin 5) | CAN | DMM-V | idle 2.3 - 2.7 V to CAN_GND, within 100 mV of K5 | the K5-K6 resistance also tells a CAN jack from the LAN jack when the silkscreen is unreadable: only J201/J202 show 124 ohm | spec | 36.64 | 85.645 | F
K7 | R202.2 | TERM_A | SW201 pole A | CAN | DMM-R | K7 to K8: under 1 ohm with SW201 IN, open with it OUT | measuring across the switch rather than the whole network separates a bad switch from a bad 62R resistor | derived | 48.0 | 77.175 | F
K8 | R203.1 | TERM_B | SW201 pole B | CAN | DMM-R | see K7 - both poles must make; one pole alone leaves 62 ohm, not 124 | SW201 is a DPST: pads 1-2 and 3-4 both land on TERM_MID, and C207 hangs off the midpoint | derived | 52.0 | 78.825 | F
K9 | U201.8 | VCC_5V | ADM3053 VDD1, system side | CAN | DMM-V | 4.70 - 5.25 V to GND | the isolated DC-DC is fed from 5 V, not 3.3 V - a common mis-wire | derived | 43.825 | 65.35 | F
K10 | U201.6 | VCC_3V3 | ADM3053 VIO, logic side | CAN | DMM-V | 3.23 - 3.43 V to GND | VIO sets the logic level the S3 sees; 5 V here would damage the S3 | derived | 46.365 | 65.35 | F
