stoatworks-labs/canary/hardware/canary.kicad_pcb

## KiCad design hardware/canary.kicad_pcb (2026-09-27)

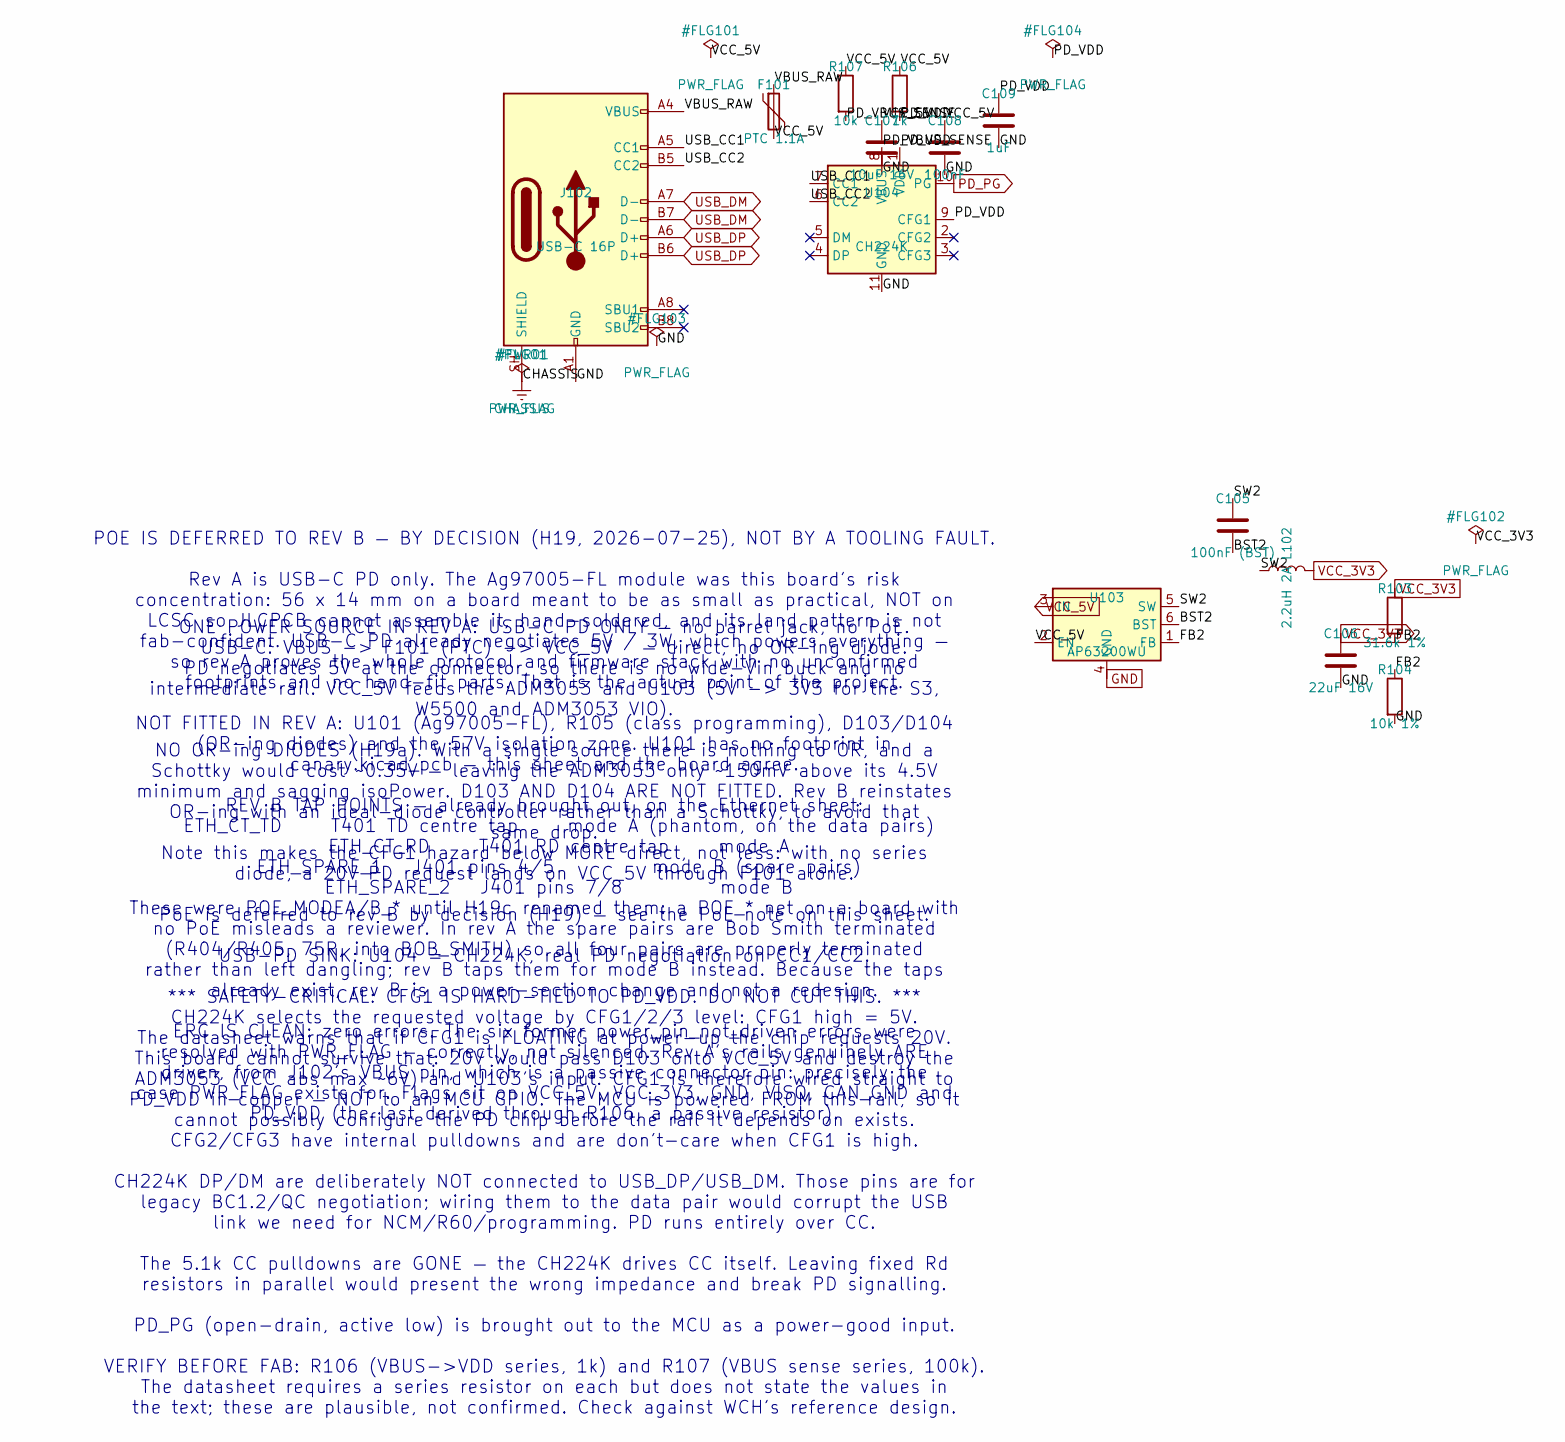
[picture p18: schematic power.kicad_sch]

Parts:
C105: 100nF (BST); C_0402_1005Metric
C106: 22uF 16V; C_0805_2012Metric
C107: 10uF 16V; C_0805_2012Metric
C108: 100nF; C_0402_1005Metric
C109: 1uF; C_0402_1005Metric
F101: PTC 1.1A; Fuse_1206_3216Metric
J102: USB-C 16P; USB_C_Receptacle_HRO_TYPE-C-31-M-12
L102: 2.2uH 2A; L_Bourns-SRN4018
R103: 31.6k 1%; R_0402_1005Metric
R104: 10k 1%; R_0402_1005Metric
R106: 1k; R_0402_1005Metric
R107: 10k; R_0402_1005Metric
U103: AP63200WU; TSOT-23-6
U104: CH224K; SSOP-10-1EP_3.9x4.9mm_P1mm_EP2.1x3.3mm

Connections:
/Power — PoE + USB-C PD, 5V and 3V3/BST2: C105.2, U103.6 (BST)
/Power — PoE + USB-C PD, 5V and 3V3/FB2: R103.2, R104.1, U103.1 (FB)
/Power — PoE + USB-C PD, 5V and 3V3/PD_VBUS_SENSE: R107.2, U104.8 (VBUS)
/Power — PoE + USB-C PD, 5V and 3V3/PD_VDD: C109.1, R106.2, U104.1 (VDD), U104.9 (CFG1)
/Power — PoE + USB-C PD, 5V and 3V3/SW2: C105.1, L102.1, U103.5 (SW)
/Power — PoE + USB-C PD, 5V and 3V3/USB_CC1: J102.A5 (CC1), U104.7 (CC1)
/Power — PoE + USB-C PD, 5V and 3V3/USB_CC2: J102.B5 (CC2), U104.6 (CC2)
/Power — PoE + USB-C PD, 5V and 3V3/VBUS_RAW: F101.1, J102.A4 (VBUS), J102.A9 (VBUS), J102.B4 (VBUS), J102.B9 (VBUS)
CHASSIS: J102.SH (SHIELD); also elsewhere on the board
GND: C106.2, C107.2, C108.2, C109.2, J102.A1 (GND), J102.A12 (GND), J102.B1 (GND), J102.B12 (GND), R104.2, U103.4 (GND), U104.11 (GND); also elsewhere on the board
PD_PG: U104.10 (PG); also elsewhere on the board
USB_DM: J102.A7 (D-), J102.B7 (D-); also elsewhere on the board
USB_DP: J102.A6 (D+), J102.B6 (D+); also elsewhere on the board
VCC_3V3: C106.1, L102.2, R103.1; also elsewhere on the board
VCC_5V: C107.1, C108.1, F101.2, R106.1, R107.1, U103.2 (EN), U103.3 (IN); also elsewhere on the board

Notes on the sheet:
ONE POWER SOURCE IN REV A: USB-C PD ONLY — no barrel jack, no PoE. USB-C: VBUS -> F101 (PTC) -> VCC_5V — direct, no OR-ing diode. PD negotiates 5V at the connector, so there is no wide-Vin buck and no intermediate rail. VCC_5V feeds the ADM3053 and U103 (5V -> 3V3 for the S3, W5500 and ADM3053 VIO)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
POE IS DEFERRED TO REV B — BY DECISION (H19, 2026-07-25), NOT BY A TOOLING FAULT. Rev A is USB-C PD only. The Ag97005-FL module was this board's risk concentration: 56 x 14 mm on a board meant to be as small as practical, NOT on LCSC so JLCPCB cannot assemble it, hand-soldered, and its land pattern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

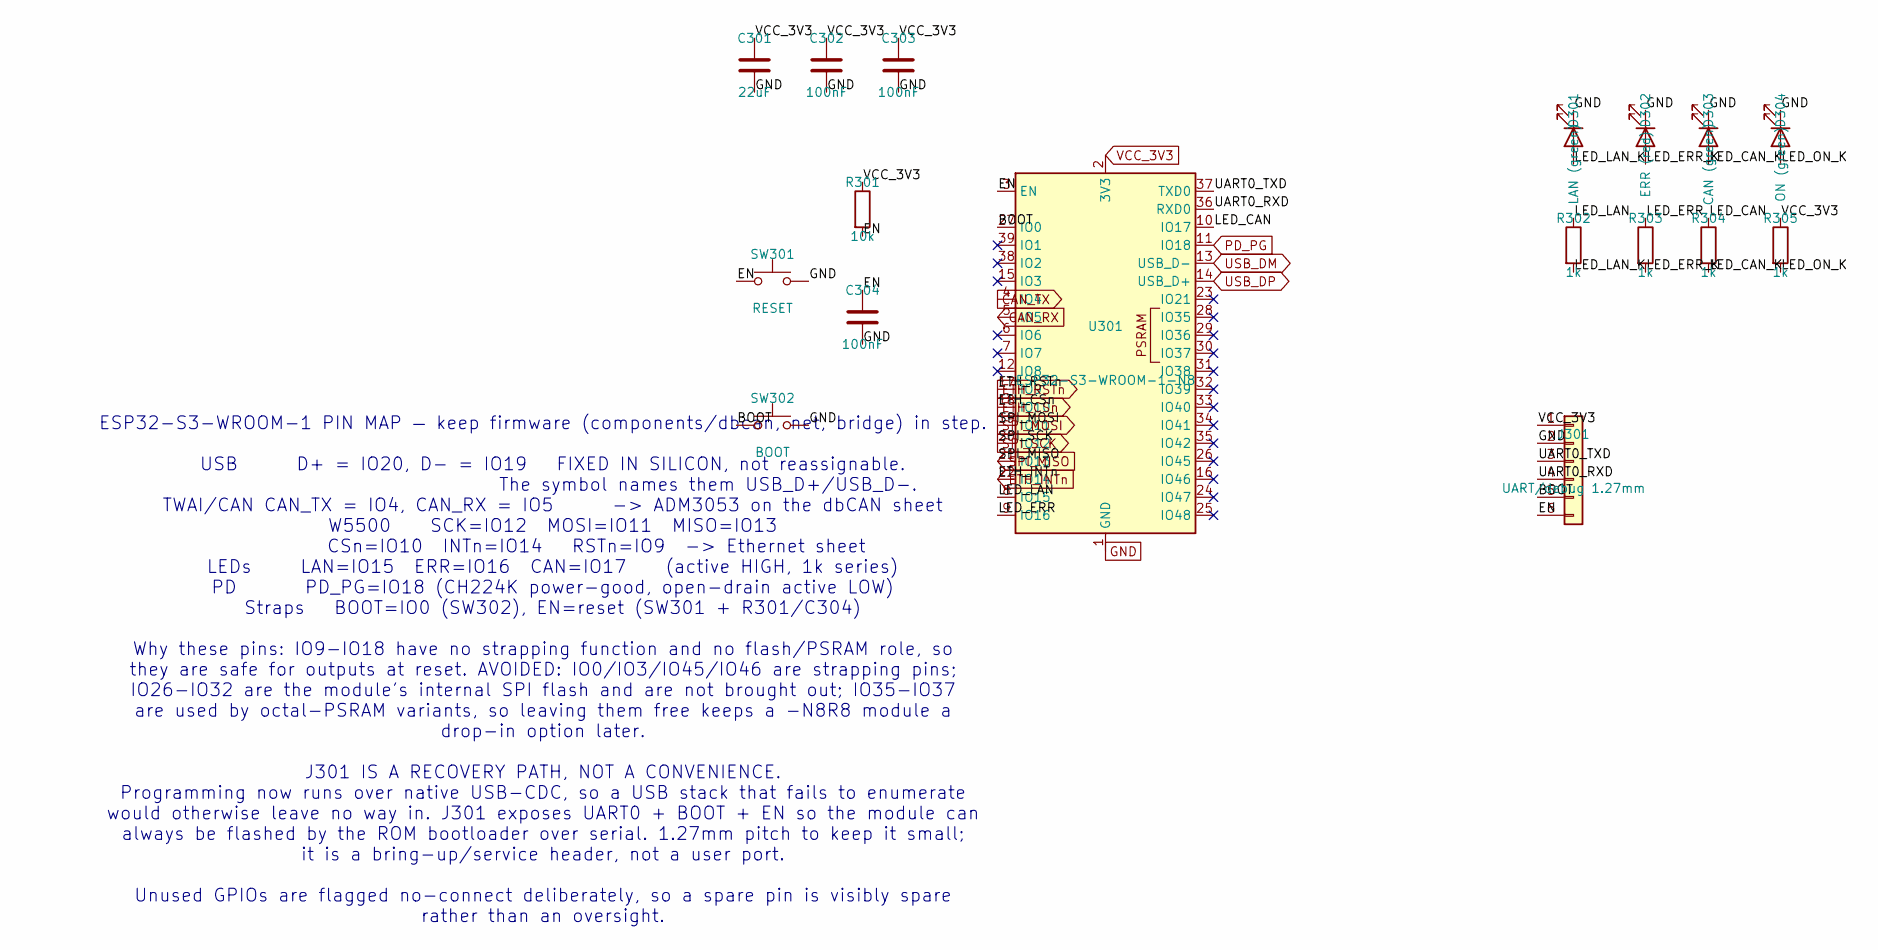
[picture p19: schematic mcu.kicad_sch]

Parts:
C301: 22uF; C_0805_2012Metric
C302, C303, C304: 100nF; C_0402_1005Metric
D301: LAN (green); LED_0603_1608Metric
D302: ERR (red); LED_0603_1608Metric
D303: CAN (green); LED_0603_1608Metric
D304: ON (green); LED_0603_1608Metric
J301: UART/debug 1.27mm; PinHeader_1x06_P1.27mm_Vertical
R301: 10k; R_0402_1005Metric
R302, R303, R304, R305: 1k; R_0402_1005Metric
SW301: RESET; SW_SPST_PTS645Sx43SMTR92
SW302: BOOT; SW_SPST_PTS645Sx43SMTR92
U301: ESP32-S3-WROOM-1-N8; ESP32-S3-WROOM-1

Connections:
/MCU — ESP32-S3-WROOM-1, USB, LEDs/BOOT: J301.5, SW302.1, U301.27 (IO0)
/MCU — ESP32-S3-WROOM-1, USB, LEDs/EN: C304.1, J301.6, R301.2, SW301.1, U301.3 (EN)
/MCU — ESP32-S3-WROOM-1, USB, LEDs/LED_CAN: R304.1, U301.10 (IO17)
/MCU — ESP32-S3-WROOM-1, USB, LEDs/LED_CAN_K: D303.2 (A), R304.2
/MCU — ESP32-S3-WROOM-1, USB, LEDs/LED_ERR: R303.1, U301.9 (IO16)
/MCU — ESP32-S3-WROOM-1, USB, LEDs/LED_ERR_K: D302.2 (A), R303.2
/MCU — ESP32-S3-WROOM-1, USB, LEDs/LED_LAN: R302.1, U301.8 (IO15)
/MCU — ESP32-S3-WROOM-1, USB, LEDs/LED_LAN_K: D301.2 (A), R302.2
/MCU — ESP32-S3-WROOM-1, USB, LEDs/LED_ON_K: D304.2 (A), R305.2
/MCU — ESP32-S3-WROOM-1, USB, LEDs/UART0_RXD: J301.4, U301.36 (RXD0)
/MCU — ESP32-S3-WROOM-1, USB, LEDs/UART0_TXD: J301.3, U301.37 (TXD0)
CAN_RX: U301.5 (IO5); also elsewhere on the board
CAN_TX: U301.4 (IO4); also elsewhere on the board
ETH_CSn: U301.18 (IO10); also elsewhere on the board
ETH_INTn: U301.22 (IO14); also elsewhere on the board
ETH_RSTn: U301.17 (IO9); also elsewhere on the board
GND: C301.2, C302.2, C303.2, C304.2, D301.1 (K), D302.1 (K), D303.1 (K), D304.1 (K), J301.2, SW301.2, SW302.2, U301.1 (GND), U301.40 (GND), U301.41 (GND); also elsewhere on the board
PD_PG: U301.11 (IO18); also elsewhere on the board
SPI_MISO: U301.21 (IO13); also elsewhere on the board
SPI_MOSI: U301.19 (IO11); also elsewhere on the board
SPI_SCK: U301.20 (IO12); also elsewhere on the board
USB_DM: U301.13 (USB_D-); also elsewhere on the board
USB_DP: U301.14 (USB_D+); also elsewhere on the board
VCC_3V3: C301.1, C302.1, C303.1, J301.1, R301.1, R305.1, U301.2 (3V3); also elsewhere on the board

Notes on the sheet:
ESP32-S3-WROOM-1 PIN MAP — keep firmware (components/dbcan, net, bridge) in step. USB D+ = IO20, D- = IO19 FIXED IN SILICON, not reassignable. The symbol names them USB_D+/USB_D-. TWAI/CAN CAN_TX = IO4, CAN_RX = IO5 -> ADM3053 on the dbCAN sheet W5500 SCK=IO12 MOSI=IO11 MISO=IO13 CSn=IO10 INTn=IO14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

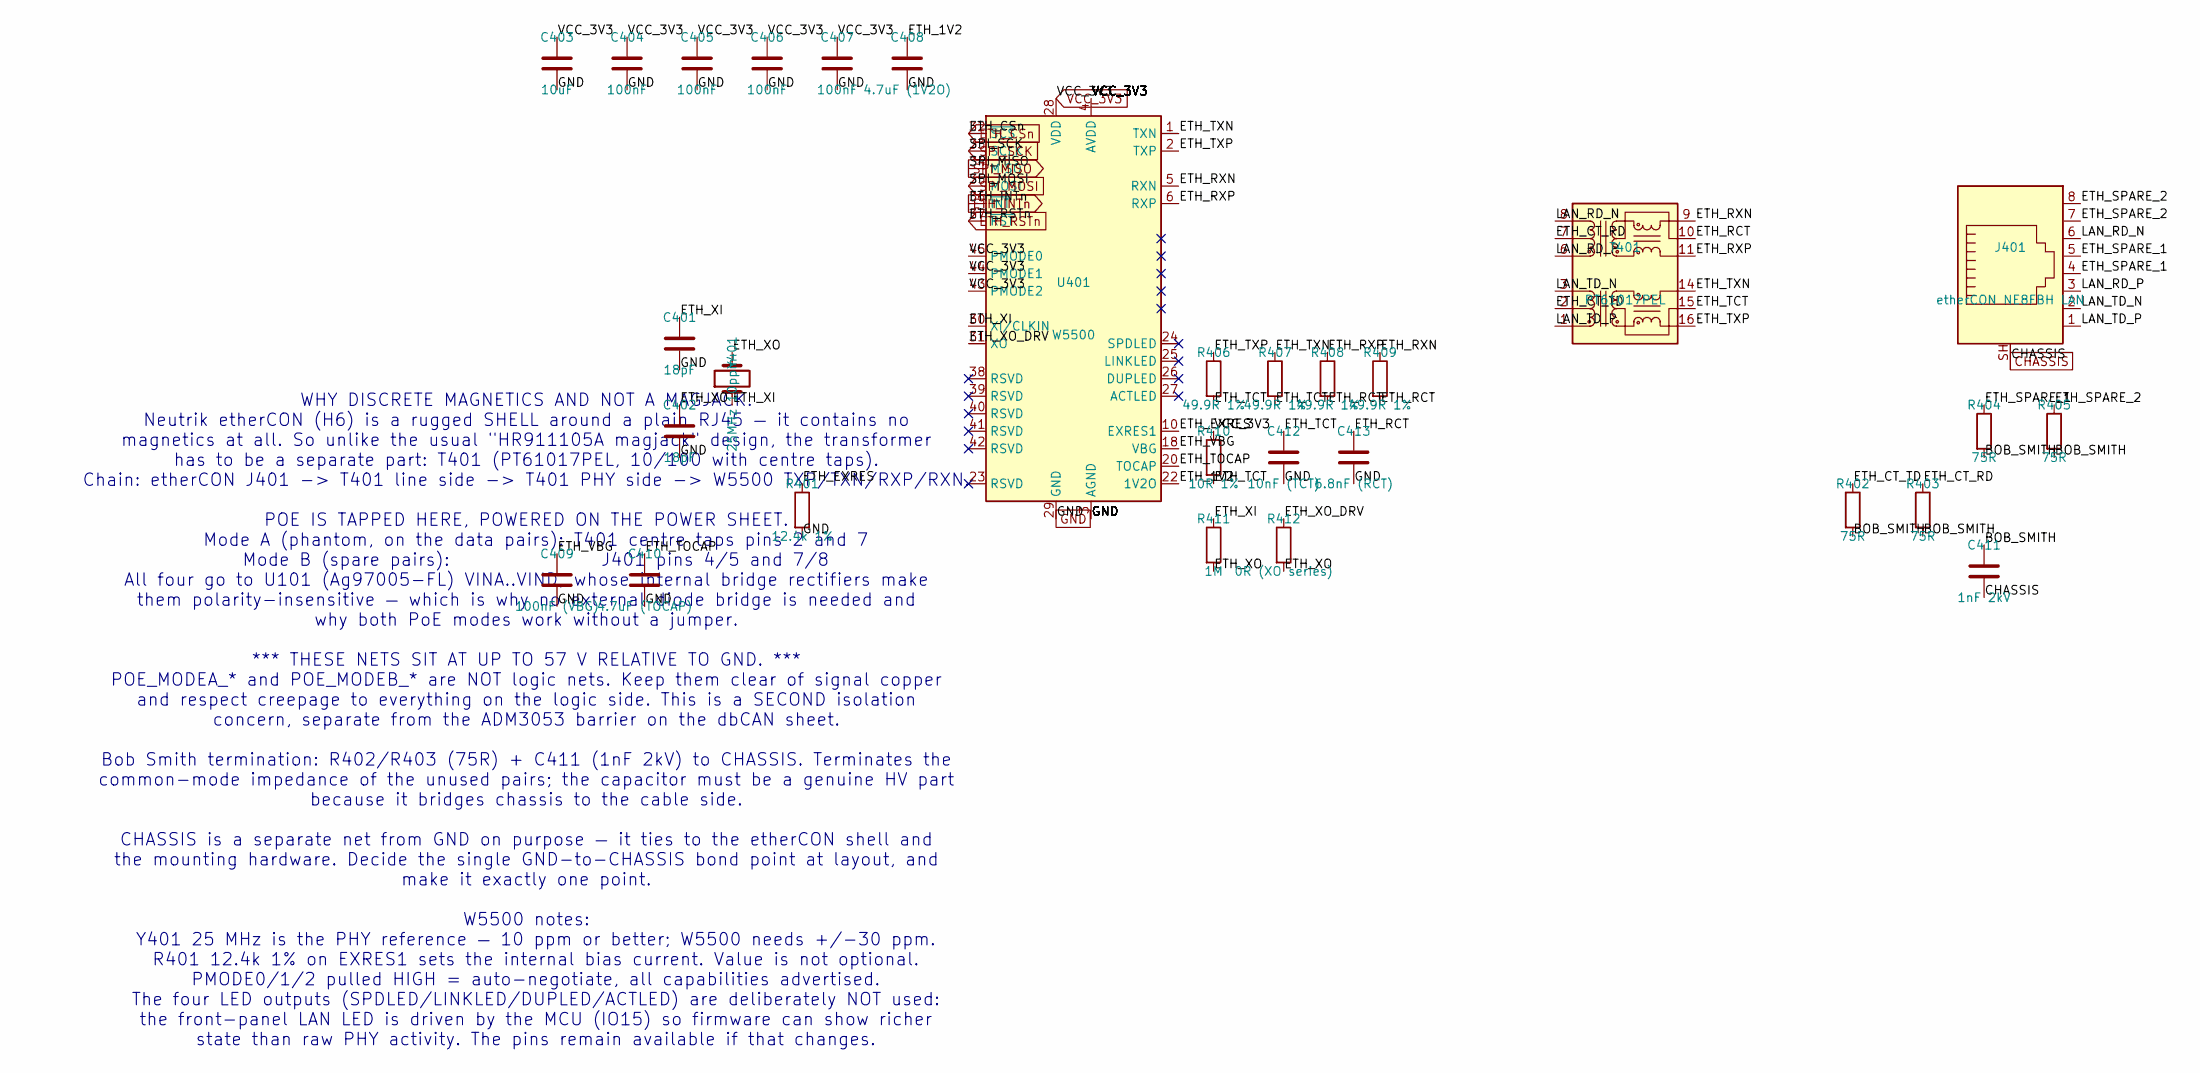
[picture p20: schematic ethernet.kicad_sch]

Parts:
C401, C402: 18pF; C_0402_1005Metric
C403: 10uF; C_0805_2012Metric
C404, C405, C406, C407: 100nF; C_0402_1005Metric
C408: 4.7uF (1V2O); C_0603_1608Metric
C409: 100nF (VBG); C_0402_1005Metric
C410: 4.7uF (TOCAP); C_0603_1608Metric
C411: 1nF 2kV; C_1206_3216Metric
C412: 10nF (TCT); C_0402_1005Metric
C413: 6.8nF (RCT); C_0402_1005Metric
J401: etherCON NE8FBH LAN; Neutrik_etherCON_NE8FBH
R401: 12.4k 1%; R_0402_1005Metric
R402, R403, R404, R405: 75R; R_0603_1608Metric
R406, R407, R408, R409: 49.9R 1%; R_0402_1005Metric
R410: 10R 1%; R_0402_1005Metric
R411: 1M; R_0402_1005Metric
R412: 0R (XO series); R_0402_1005Metric
T401: PT61017PEL; Transformer_Ethernet_Bourns_PT61017PEL
U401: W5500; LQFP-48_7x7mm_P0.5mm
Y401: 25MHz 10ppm; Crystal_SMD_3225-4Pin_3.2x2.5mm

Connections:
/Ethernet — W5500 SPI, PoE magjack, etherCON/BOB_SMITH: C411.1, R402.2, R403.2, R404.2, R405.2
/Ethernet — W5500 SPI, PoE magjack, etherCON/ETH_1V2: C408.1, U401.22 (1V2O)
/Ethernet — W5500 SPI, PoE magjack, etherCON/ETH_CT_RD: R403.1, T401.7 (C_RD)
/Ethernet — W5500 SPI, PoE magjack, etherCON/ETH_CT_TD: R402.1, T401.2 (C_TD)
/Ethernet — W5500 SPI, PoE magjack, etherCON/ETH_EXRES: R401.1, U401.10 (EXRES1)
/Ethernet — W5500 SPI, PoE magjack, etherCON/ETH_RCT: C413.1, R408.2, R409.2, T401.10 (C_RX)
/Ethernet — W5500 SPI, PoE magjack, etherCON/ETH_RXN: R409.1, T401.9 (RX-), U401.5 (RXN)
/Ethernet — W5500 SPI, PoE magjack, etherCON/ETH_RXP: R408.1, T401.11 (RX+), U401.6 (RXP)
/Ethernet — W5500 SPI, PoE magjack, etherCON/ETH_SPARE_1: J401.4, J401.5, R404.1
/Ethernet — W5500 SPI, PoE magjack, etherCON/ETH_SPARE_2: J401.7, J401.8, R405.1
/Ethernet — W5500 SPI, PoE magjack, etherCON/ETH_TCT: C412.1, R406.2, R407.2, R410.2, T401.15 (C_TX)
/Ethernet — W5500 SPI, PoE magjack, etherCON/ETH_TOCAP: C410.1, U401.20 (TOCAP)
/Ethernet — W5500 SPI, PoE magjack, etherCON/ETH_TXN: R407.1, T401.14 (TX-), U401.1 (TXN)
/Ethernet — W5500 SPI, PoE magjack, etherCON/ETH_TXP: R406.1, T401.16 (TX+), U401.2 (TXP)
/Ethernet — W5500 SPI, PoE magjack, etherCON/ETH_VBG: C409.1, U401.18 (VBG)
/Ethernet — W5500 SPI, PoE magjack, etherCON/ETH_XI: C401.1, R411.1, U401.30 (XI/CLKIN), Y401.1
/Ethernet — W5500 SPI, PoE magjack, etherCON/ETH_XO: C402.1, R411.2, R412.2, Y401.2
/Ethernet — W5500 SPI, PoE magjack, etherCON/ETH_XO_DRV: R412.1, U401.31 (XO)
/Ethernet — W5500 SPI, PoE magjack, etherCON/LAN_RD_N: J401.6, T401.8 (RD-)
/Ethernet — W5500 SPI, PoE magjack, etherCON/LAN_RD_P: J401.3, T401.6 (RD+)
/Ethernet — W5500 SPI, PoE magjack, etherCON/LAN_TD_N: J401.2, T401.3 (TD-)
/Ethernet — W5500 SPI, PoE magjack, etherCON/LAN_TD_P: J401.1, T401.1 (TD+)
CHASSIS: C411.2, J401.SH; also elsewhere on the board
ETH_CSn: U401.32 (~SCS); also elsewhere on the board
ETH_INTn: U401.36 (~INT); also elsewhere on the board
ETH_RSTn: U401.37 (~RST); also elsewhere on the board
GND: C401.2, C402.2, C403.2, C404.2, C405.2, C406.2, C407.2, C408.2, C409.2, C410.2, C412.2, C413.2, R401.2, U401.3 (AGND), U401.9 (AGND), U401.14 (AGND), U401.16 (AGND), U401.19 (AGND), U401.29 (GND), U401.48 (AGND); also elsewhere on the board
SPI_MISO: U401.34 (MISO); also elsewhere on the board
SPI_MOSI: U401.35 (MOSI); also elsewhere on the board
SPI_SCK: U401.33 (SCLK); also elsewhere on the board
VCC_3V3: C403.1, C404.1, C405.1, C406.1, C407.1, R410.1, U401.4 (AVDD), U401.8 (AVDD), U401.11 (AVDD), U401.15 (AVDD), U401.17 (AVDD), U401.21 (AVDD), U401.28 (VDD), U401.43 (PMODE2), U401.44 (PMODE1), U401.45 (PMODE0); also elsewhere on the board

Notes on the sheet:
WHY DISCRETE MAGNETICS AND NOT A MAGJACK. Neutrik etherCON (H6) is a rugged SHELL around a plain RJ45 — it contains no magnetics at all. So unlike the usual "HR911105A magjack" design, the transformer has to be a separate part: T401 (PT61017PEL, 10/100 with centre taps). Chain: etherCON J401 -> T40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

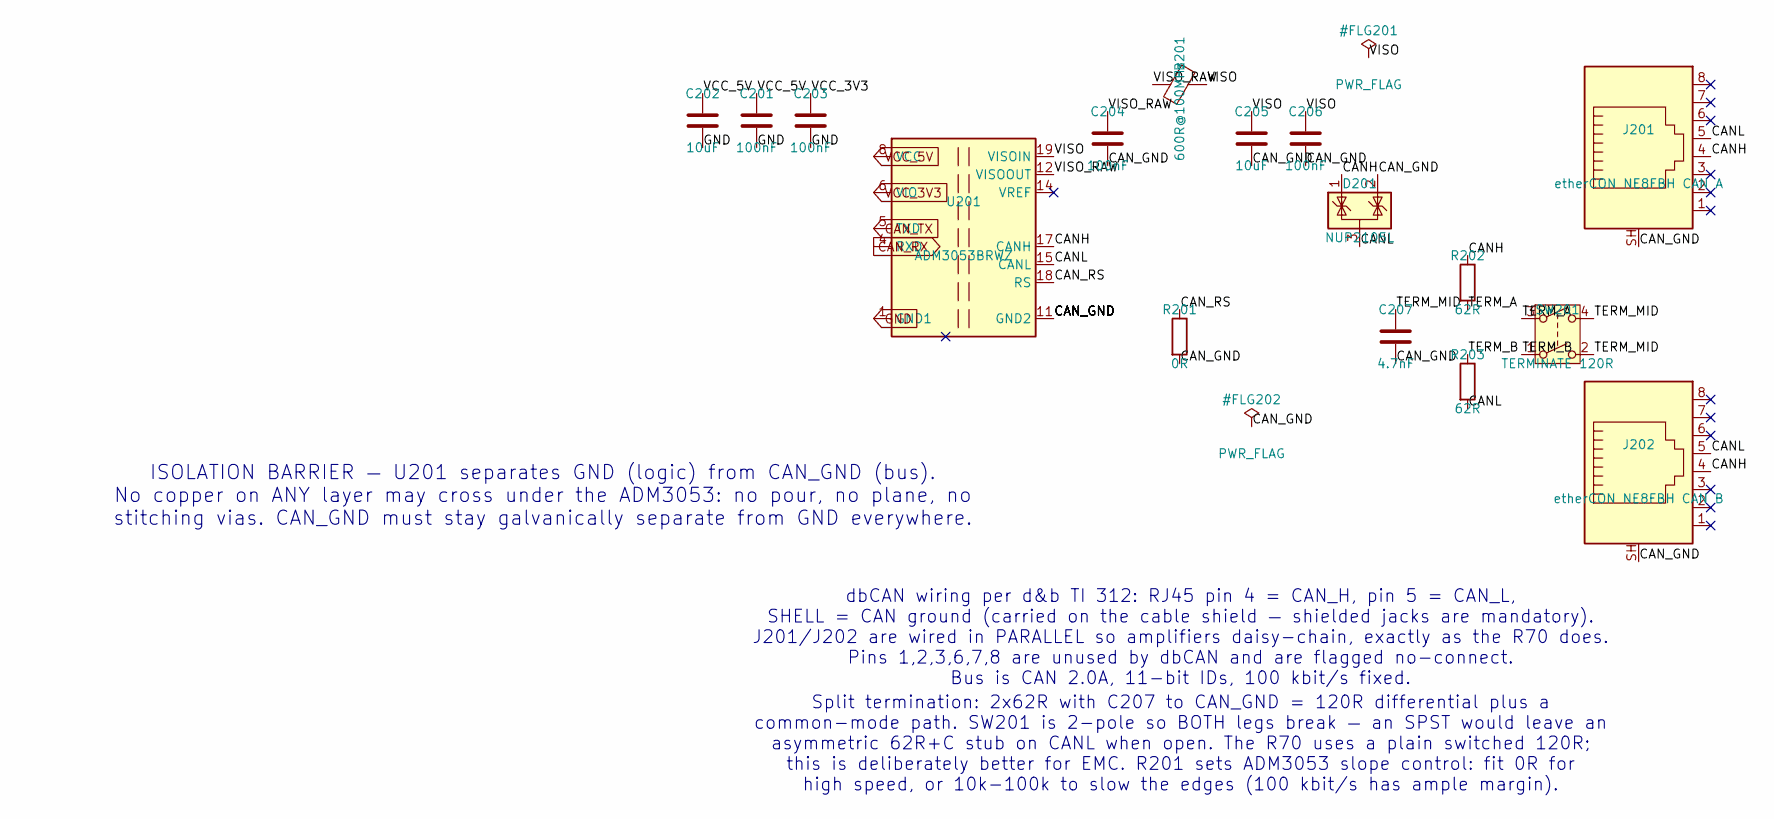
[picture p21: schematic can.kicad_sch]

Parts:
C201, C203, C204, C206: 100nF; C_0402_1005Metric
C202, C205: 10uF; C_0805_2012Metric
C207: 4.7nF; C_0603_1608Metric
D201: NUP2105L; SOT-23
FB201: 600R@100MHz; L_0603_1608Metric
J201: etherCON NE8FBH CAN A; Neutrik_etherCON_NE8FBH
J202: etherCON NE8FBH CAN B; Neutrik_etherCON_NE8FBH
R201: 0R; R_0402_1005Metric
R202, R203: 62R; R_0603_1608Metric
SW201: TERMINATE 120R; SW_DIP_SPSTx02_Slide_9.78x7.26mm_W7.62mm_P2.54mm
U201: ADM3053BRWZ; SOIC-20W_7.5x12.8mm_P1.27mm

Connections:
/dbCAN — ADM3053 isolated, 2x etherCON/CANH: D201.1 (K), J201.4, J202.4, R202.1, U201.17 (CANH)
/dbCAN — ADM3053 isolated, 2x etherCON/CANL: D201.3 (A), J201.5, J202.5, R203.2, U201.15 (CANL)
/dbCAN — ADM3053 isolated, 2x etherCON/CAN_GND: C204.2, C205.2, C206.2, C207.2, D201.2 (K), J201.SH, J202.SH, R201.2, U201.11 (GND2), U201.13 (GND2), U201.16 (GND2), U201.20 (GND2)
/dbCAN — ADM3053 isolated, 2x etherCON/CAN_RS: R201.1, U201.18 (RS)
/dbCAN — ADM3053 isolated, 2x etherCON/TERM_A: R202.2, SW201.3
/dbCAN — ADM3053 isolated, 2x etherCON/TERM_B: R203.1, SW201.1
/dbCAN — ADM3053 isolated, 2x etherCON/TERM_MID: C207.1, SW201.2, SW201.4
/dbCAN — ADM3053 isolated, 2x etherCON/VISO: C205.1, C206.1, FB201.2, U201.19 (VISOIN)
/dbCAN — ADM3053 isolated, 2x etherCON/VISO_RAW: C204.1, FB201.1, U201.12 (VISOOUT)
CAN_RX: U201.4 (RXD); also elsewhere on the board
CAN_TX: U201.5 (TXD); also elsewhere on the board
GND: C201.2, C202.2, C203.2, U201.1 (GND1), U201.3 (GND1), U201.7 (GND1), U201.9 (GND1), U201.10 (GND1); also elsewhere on the board
VCC_3V3: C203.1, U201.6 (VIO); also elsewhere on the board
VCC_5V: C201.1, C202.1, U201.8 (VCC); also elsewhere on the board

Notes on the sheet:
ISOLATION BARRIER — U201 separates GND (logic) from CAN_GND (bus). No copper on ANY layer may cross under the ADM3053: no pour, no plane, no stitching vias. CAN_GND must stay galvanically separate from GND everywhere.
dbCAN wiring per d&b TI 312: RJ45 pin 4 = CAN_H, pin 5 = CAN_L, SHELL = CAN ground (carried on the cable shield — shielded jacks are mandatory). J201/J202 are wired in PARALLEL so amplifiers daisy-chain, exactly as the R70 does. Pins 1,2,3,6,7,8 are unused by dbCAN and are flagged no-connect. Bus i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
Split termination: 2x62R with C207 to CAN_GND = 120R differential plus a common-mode path. SW201 is 2-pole so BOTH legs break — an SPST would leave an asymmetric 62R+C stub on CANL when open. The R70 uses a plain switched 120R; this is deliberately better for EMC. R201 sets ADM3053 slope control: f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

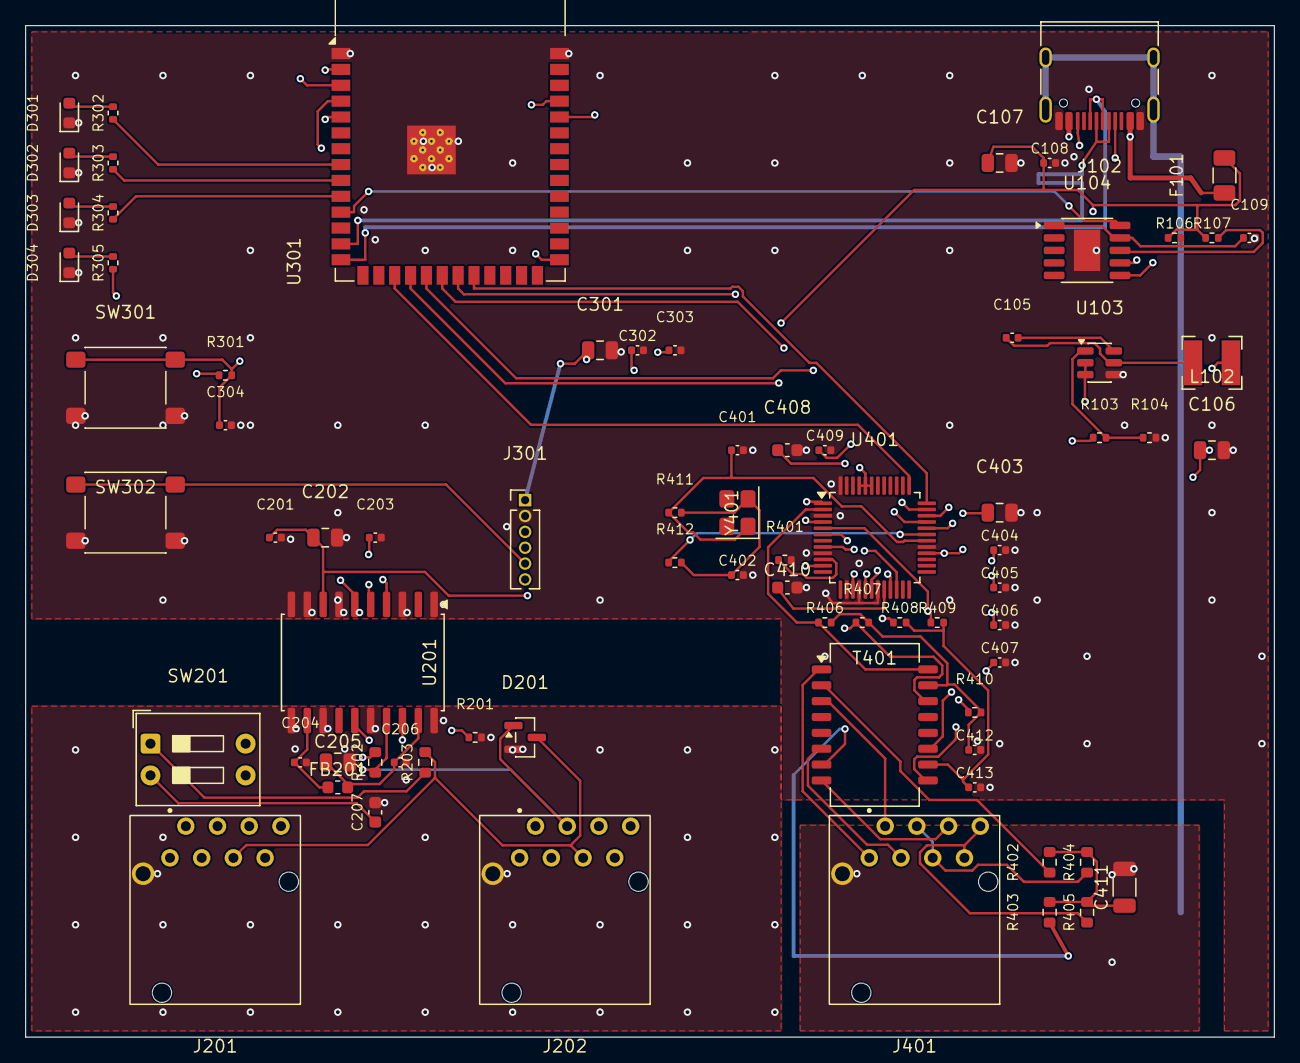
[picture p22: board canary.kicad_pcb from above]

Board: 4 copper layers, 100.0 x 81.0 mm, 76 parts (0 on the bottom side), 65 nets.
