stoatworks-labs/canary/(commit log)

2026-09-26 dbCANary 0.1.0: rev A board, tube enclosure, firmware main-60a871f
    First public release of the prototype. Hardware rev A (KiCad, fab outputs,
    bring-up records), the one-piece tube enclosure with its LED insert and
    switch cover, and the firmware, host tools and tests.
    [NETLIST-CROSSREF.csv, PROBE-POINTS.csv, can.kicad_sch, dbcanary-4up-absgf-0.4-tube-x4.3mf, dbcanary-bom.csv, dbcanary-case-absgf-0.4-tube.3mf, dbcanary-jlcpcb-bom.csv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]
2026-09-27 CANary: rename, default name in R1, flush switch cover, insert jig
    - Renamed dbCANary -> CANary across docs, firmware, tools, enclosure and the
    KiCad project (files and footprint library nickname). The firmware's NVS
    settings namespace keeps its old name so configured units keep their
    settings; the 0.1.0 changelog entry and board #1's bring-up log and test
    record keep the name they were written under.
    - A unit is listed in R1 as "CANary" by default, not the R70 factory "db-70".
    - The tube's switch cover sits flush in a 1.2 mm pocket in the lid, with a
    lever notch for a small screwdriver. Not interchangeable with 0.1.0 parts.
    - Heat-set insert jig for a common 3D-printed insert pres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
    [can.kicad_sch, canary-4up-absgf-0.4-tube-x4.3mf, canary-bom.csv, canary-case-absgf-0.4-tube.3mf, canary-insert-jig-pla-0.4-jig.3mf, canary-jlcpcb-bom.csv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]
2026-09-27 Tube: internal bracing
    Three hoop bands round the inside of the section, with 45-degree undersides so
    the tube still prints on end with no support, and four full-length ribs,
    all clear of the board path, the etherCONs, the USB-C well and the insert
    pilots (checked on the built solid). +6 g a case; stiffness gain not measured.
    [canary-4up-absgf-0.4-tube-x4.3mf, canary-case-absgf-0.4-tube.3mf, canary_case_assembly.step, canary_tube.step, canary_tube.stl]
2026-10-12 Docs: the USB link, the web UI and the board caught up with board #1
    - docs/USER-GUIDE.md §10, docs/WEBUI.md (status and §6) and docs/USB-NIC.md §6
    said no computer had ever enumerated the USB network device and webui.c had
    only been compiled. docs/USB-NIC.md §7 records the first bench session
    (2026-09-26, board #1, macOS 26.4): it enumerated, leased 192.168.7.2,
    `http://192.168.7.1/` returned 200 and board_test.py passed 19/19 over USB
    (canary-dev 60a871f, which also fixed the web UI's guard refusing the USB
    host). Now: proven on a Mac only; nothing past serving the page is recorded
    for the web UI; discovery over USB and Windows still untried.
    - docs/USER-GUIDE.md §0 said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
2026-10-24 Changelog: the 2026-09-27 changes are 0.2.0
    They sat under "Unreleased" after 0.2.0 was released on 2026-10-19. The
    entry now says what the release added (firmware main-ff4110d as one zip
    with a manifest) and that main-ff4110d hasn't been on a board yet.
2026-10-29 Docs: board #1 on a real CAN bus, and the fault it found
    On 2026-10-28 board #1 went on a real bus with two d&b amplifiers. The status
    text still said CAN had only talked to itself.
    - hardware/fab/test/BRINGUP-LOG-0001.md: new §12, a redacted summary of the
    day. Stages A (both CAN jacks, both amplifiers answering through the
    isolation barrier, bus_err 0), B (board_test.py 18/0/2, a bridge check 19/19
    twice) and C (listed as CANary-UDP-CLIENT-30000, connected over TCP 30000,
    mute and gain in both directions) passed. Stage D found that after a CAN
    cable pull the CAN side never recovers until reset: recovery runs only on
    0x58, which the control application never sends. The firmwar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
